AnikS22/golf-cart-code/Hardware/OneDrive_1_5-1-2026/Arduino Code/PGN Data.docx

PGN: 65300 Src: 0xFF Dest: 0x475

PGN: 61444 Src: 0xFF Dest: 0x475 Electronic Engine Controller 1

## 4th bit is voltage most likely and 5th bit is possibly speed

## Voltage pins right above pedal, able to measure

PGN: 61445 Src: 0xFF Dest: 0x475 Electronic Transmission Controller 2

## Forward = 70 6th

## Neutral = 78 6th

## Charging = 67 6th

## Reverse = : 255 255 255 255 32 82 255 25 6th

PGN: 61446 Src: 0xFF Dest: 0x475 Electronic Axle Controller 1

PGN: 64991 Src: 0xFF Dest: 0x475 Front wheel drive status

## Always null, possible lock up status

PGN: 65299 Src: 0xFF Dest: 0x475 -Change with no input

PGN: 65382 Src: 0xFF Dest: 0x475

PGN: 65265 Src: 0xFF Dest: 0x475 Cruise control/Vehicle Speed 1

## 3rd and 4th bit, 4th bit is most likely speed in mph

PGN: 15990542 Src: 0xFF Dest: 0x475

PGN: 15728391 Src: 0xFF Dest: 0x475 - Change with no input

PGN: 15990543 Src: 0xFF Dest: 0x475 - Change with no input

PGN: 15990545 Src: 0xFF Dest: 0x475 - Change with no input

PGN: 15990546 Src: 0xFF Dest: 0x475 -Change with no input
