AnikS22/golf-cart-code/Hardware/OneDrive_1_5-1-2026/Design Docs/Draft Accelerator Plan.xlsx

Accelerator System | 34-41 days | Comments
Reverse Engineer | 4 days | Need to find the correct bits per PGN (Basics already completed, would need to only do further reverse engineering if we get the code working)
Alternate Path if not workable | 0 - 7 days | Digital Pot, if applicable, this would take however many days shipping would be. Estimate 5-7 days for shipping
Implementing Protocol | 5 days | Getting Protocol to work (Once this works, we can control transmission/speed/etc
EMCU Selection | 1 day | Quick, once we get code working and have completed reverse engineering, picking EMCU with proper capatability will be easy.
Jetson to ECU Communcation code | 0 days | Would be done parallel to Electrical work
Mechanical Design for Mounting | 7 days | Planning, Prototyping, Troubleshooting, and Finalizing. This step is more tedious since we are using various boards.
Electrical Design | 7 days | Powering the arduino and jetson from the cart's battery
Electrical Validation | 3 days
Quality Control and Testing | 7 days | Want to go outside and test the cart, read temperatures of boards and ensure that the boards wont overheat
Electrical
Software
Mechanical
IDT
Accelerator System Complete | 34-41 days
