AnikS22/golf-cart-code/Hardware/OneDrive_1_5-1-2026/Design Docs/Draft Braking Plan.xlsx

Braking System | 56 days?
Evaluate Master Cylinder | 1 day?
Parts selection | 1 day?
Procurement | 1 day?
fabrication | 1 day?
Electrical Validation | 1 day?
 | 1 day?
Electrical | 5 days
Software | 5 days
Mechanical | 5 days
IDT | 5 days
Control System Complete | 0 days
CAD-modeling cockpit structure | 1-2 Weeks?
Basic (kinematic) concept of actuator with emergency override feature | 1-2 Weeks?
Force/stress analysis/synthesis | 1-2 Weeks?
IF APPLICABLE: 3D-printing/other mode of prototyping
Detailed design (fasteners, actuator types, etc.)
Spec'ing and selection of actuator and other components
Purchase
