AnikS22/golf-cart-code/Hardware/OneDrive_1_5-1-2026/Design Docs/Draft Control System Plan.xlsx

Control System | 36 days?
Assemble ROS Team | 1 day?
Evaluate ROS | 1 day?
Plan Implementation | 1 day?
 | 1 day?
Prototype Control System (not ROS) | 1 day?
Design wireless/wired hand controller
Design Arduino as controller
implement Prototype
 | 1 day?
Electrical | 5 days
Software | 5 days
Mechanical | 5 days
IDT | 5 days
Control System Complete | 0 days?
