AnikS22/golf-cart-code/Hardware/OneDrive_1_5-1-2026/Design Docs/Draft Steering Plan.xlsx

Steering System | 10 days?
Parts Selection | 1 day?
Procurement | 1 week?
Fabrication | 1 day?
3D Print Brackets | 1.5 weeks?
CNC Brackets | 1 week?
Assemble | 1 day?
Validate Assembly | 1 day?
Unit Test | 3 days?
Electrical Design | 1 day?
Electrical Validation | 1 day?
 | 1 day?
Electrical | 5 days
Software | 5 days
Mechanical | 5 days
IDT | 5 days
Steering System Complete | 0 days
