AnikS22/golf-cart-code/Hardware/OneDrive_1_5-1-2026/Design Docs/Resource Assignments.xlsx

Diego Jerez - Comp Sci | Accelerator
Yu ‘Joey’ Wu | Accelerator
Art Rozenbaum | Brakes
Kurtis Rodriques | Brakes
Louis-Cristophe Fortier | Brakes
Brandon Jadotte | Control System
Matt Trask | Control System
Michael Teti | ML
Chris Teti | Steering
Gregory Morrison - Mechanical | Steering
Tai Cao - Mechanical | Steering
Daniel Marquez
Regynald Augustin
