AnikS22/golf-cart-code/Hardware/OneDrive_1_5-1-2026/Vinyl Grafx/Proof Sheet 128038 - Golf Cart Graphics.pdf

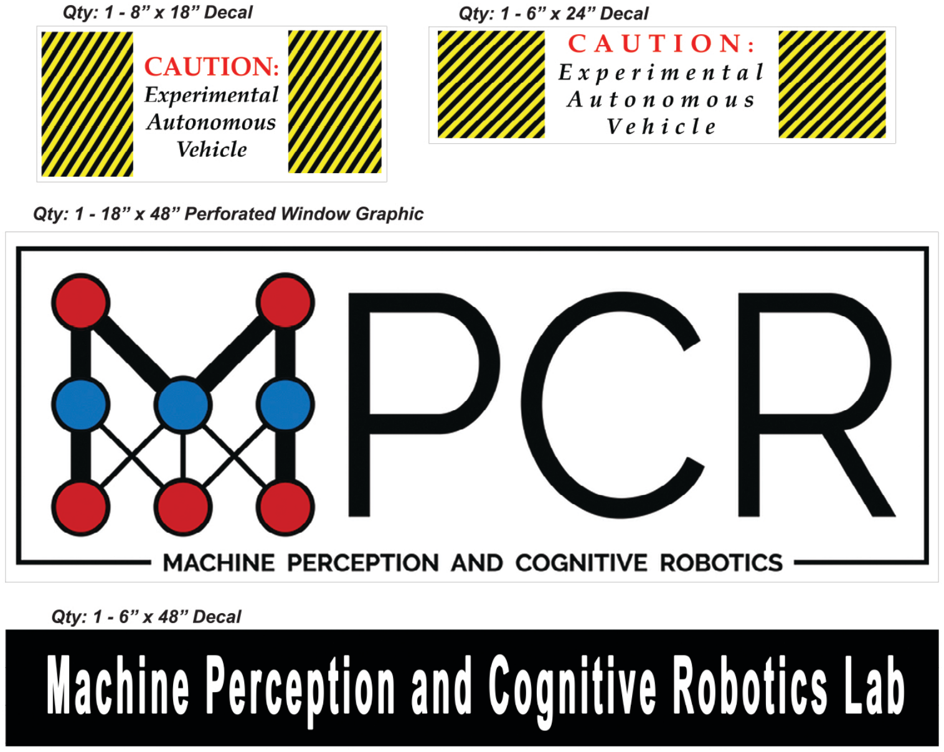
[picture p7: page 1]
