AnikS22/golf-cart-code/Old_code/steering/ReadMe.docx

READ.ME fir PiDuino Subsystem

07 Jan 2020 – PiDuino, v5 is the current working version as we add braking control

26 Dec 2019 – PiDuino,v 4 [Frozen] represents the re-constituted version that controls Steering only.

With bugfix for unsigned numbers on the LCD display.

The file “rc.local” is the autoStart file that runs the Piduino.py program as a shell process automatically on system startup. us “sudo cp rc.local /etc” in order to deploy it on a new system.

The file “PiDuino,v4 Image.dmg” is a Macintosh disk image file of the SD Card used in the Piduino. This snapshot is suitable for reproducing onto other 32gb SD cards as it contains the working image of PiDuino, v4.

NOTE: v4 is hereby frozen and the contents of this folder should not be modified. All future work begins in v5.
