AnikS22/golf-cart-code/Hardware/OneDrive_1_5-1-2026/Motor/EPAS-diagram.jpg

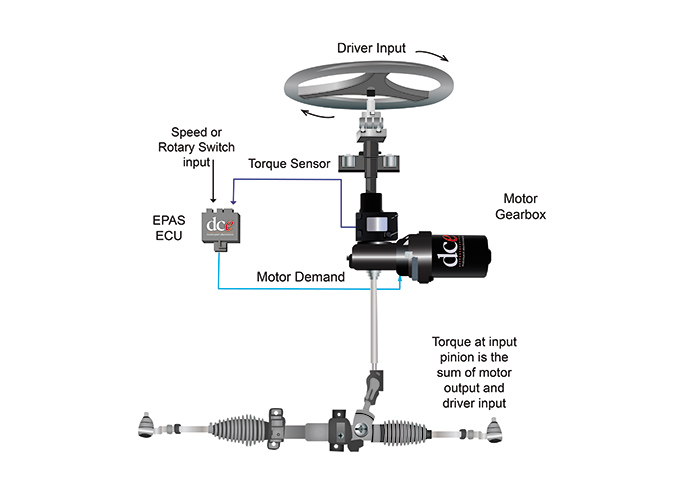
Hardware/OneDrive_1_5-1-2026/Motor/EPAS-diagram.jpg
