AnikS22/golf-cart-code/Sim/Cartagena_GEM_E4_workspace/ros2_ws/.gem.urdf

<?xml version="1.0" ?>
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
<robot name="gem_e4">
  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
  <link name="base_footprint">
  </link>
  <link name="base_link">
    <inertial>
      <origin rpy="0 0 0" xyz="-0.01178 0.0012042 0.47962"/>
      <mass value="1950.5"/>
      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
    </inertial>
    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
  </link>
  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
  <joint name="base_link" type="fixed">
    <origin rpy="0 0 0" xyz="0 0 0.268"/>
    <parent link="base_footprint"/>
    <child link="base_link"/>
  </joint>
  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
  <link name="top_rack_link">
    <inertial>
      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
      <origin rpy="0 0 0" xyz="0 0 0"/>
      <mass value="0"/>
      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
    </inertial>
    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
  </link>
  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
  <joint name="top_rack_joint" type="fixed">
    <origin rpy="1.5708 0 0" xyz="-0.17 0 1.66"/>
    <parent link="base_link"/>
    <child link="top_rack_link"/>
    <axis xyz="0 0 0"/>
  </joint>
  <link name="front_rack_link">
    <inertial>
      <origin rpy="0 0 0" xyz="0 0 0"/>
      <mass value="0"/>
      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
    </inertial>
    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
  </link>
  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
  <joint name="front_rack_joint" type="fixed">
    <origin rpy="1.5708 0 1.5708" xyz="1.7594 0 -0.15"/>
    <parent link="base_link"/>
    <child link="front_rack_link"/>
    <axis xyz="0 0 0"/>
  </joint>
  <link name="rear_rack_link">
    <inertial>
      <origin rpy="0 0 0" xyz="0 0 0"/>
      <mass value="0"/>
      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
    </inertial>
    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
  </link>
  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
  <joint name="rear_rack_joint" type="fixed">
    <origin rpy="1.5708 0 -1.5708" xyz="-1.7372 0 -0.1"/>
    <parent link="base_link"/>
    <child link="rear_rack_link"/>
    <axis xyz="0 0 0"/>
  </joint>
  <link name="headlight_fr_link">
    <inertial>
      <origin rpy="0 0 0" xyz="0 0 0"/>
      <mass value="0"/>
      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
    </inertial>
    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
  </link>
  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
  <joint name="headlight_fr_joint" type="fixed">
    <origin rpy="0 0 0" xyz="1.1677 -0.5 0.765"/>
    <parent link="base_link"/>
    <child link="headlight_fr_link"/>
    <axis xyz="0 0 0"/>
  </joint>
  <link name="headlight_fl_link">
    <inertial>
      <origin rpy="0 0 0" xyz="0 0 0"/>
      <mass value="0"/>
      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
    </inertial>
    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
  </link>
  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
  <joint name="headlight_fl_joint" type="fixed">
    <origin rpy="0 0 0" xyz="1.1677 0.5 0.765"/>
    <parent link="base_link"/>
    <child link="headlight_fl_link"/>
    <axis xyz="0 0 0"/>
  </joint>
  <link name="turnlight_fl_link">
    <inertial>
      <origin rpy="0 0 0" xyz="0 0 0"/>
      <mass value="0"/>
      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
    </inertial>
    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
  </link>
  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
  <joint name="turnlight_fl_joint" type="fixed">
    <origin rpy="0 0 0" xyz="1.1731 0.345 0.765"/>
    <parent link="base_link"/>
    <child link="turnlight_fl_link"/>
    <axis xyz="0 0 0"/>
  </joint>
  <link name="turnlight_fr_link">
    <inertial>
      <origin rpy="0 0 0" xyz="0 0 0"/>
      <mass value="0"/>
      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
    </inertial>
    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
  </link>
  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
  <joint name="turnlight_fr_joint" type="fixed">
    <origin rpy="0 0 0" xyz="1.1731 -0.345 0.765"/>
    <parent link="base_link"/>
    <child link="turnlight_fr_link"/>
    <axis xyz="0 0 0"/>
  </joint>
  <link name="lightbar_link">
    <inertial>
      <origin rpy="0 0 0" xyz="0 0 0"/>
      <mass value="0"/>
      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
    </inertial>
    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
  </link>
  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
  <joint name="lightbar_joint" type="fixed">
    <origin rpy="-1.9138 0 1.5708" xyz="-1.07655 0 0.9449"/>
    <origin rpy="0 0 0" xyz="0 0 0"/>
    <parent link="base_link"/>
    <child link="lightbar_link"/>
    <axis xyz="0 0 0"/>
  </joint>
  <link name="rear_left_stop_light_link">
    <inertial>
      <origin rpy="0 0 0" xyz="0 0 0"/>
      <mass value="0"/>
      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
    </inertial>
    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
  </link>
  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
  <joint name="stoplight_rl_joint" type="fixed">
    <origin rpy="0 0 3.1416" xyz="-1.625 0.38 0.423"/>
    <parent link="base_link"/>
    <child link="rear_left_stop_light_link"/>
    <axis xyz="0 0 0"/>
  </joint>
  <link name="rear_right_stop_light_link">
    <inertial>
      <origin rpy="0 0 0" xyz="0 0 0"/>
      <mass value="0"/>
      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
    </inertial>
    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
  </link>
  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
  <joint name="stoplight_rr_joint" type="fixed">
    <origin rpy="0 0 3.1416" xyz="-1.625 -0.38 0.423"/>
    <parent link="base_link"/>
    <child link="rear_right_stop_light_link"/>
    <axis xyz="0 0 0"/>
  </joint>
  <link name="taillight_rl_link">
    <inertial>
      <origin rpy="0 0 0" xyz="0 0 0"/>
      <mass value="0"/>
      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
    </inertial>
    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
  </link>
  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
  <joint name="taillight_rl_joint" type="fixed">
    <origin rpy="0 0 3.1416" xyz="-1.62 0.32 0.203"/>
    <parent link="base_link"/>
    <child link="taillight_rl_link"/>
    <axis xyz="0 0 0"/>
  </joint>
  <link name="taillight_rr_link">
    <inertial>
      <origin rpy="0 0 0" xyz="0 0 0"/>
      <mass value="0"/>
      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
    </inertial>
    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
  </link>
  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
  <joint name="taillight_rr_joint" type="fixed">
    <origin rpy="0 0 3.1416" xyz="-1.62 -0.32 0.203"/>
    <parent link="base_link"/>
    <child link="taillight_rr_link"/>
    <axis xyz="0 0 0"/>
  </joint>
  <link name="i_logo_fl_link">
    <inertial>
      <origin rpy="0 0 0" xyz="0 0 0"/>
      <mass value="0"/>
      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
    </inertial>
    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
  </link>
  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
  <joint name="i_logo_fl_joint" type="fixed">
    <origin rpy="0 0 0" xyz="0.3966 0.6695 0.4123"/>
    <parent link="base_link"/>
    <child link="i_logo_fl_link"/>
    <axis xyz="0 0 0"/>
  </joint>
  <link name="i_logo_rl_link">
    <inertial>
      <origin rpy="0 0 0" xyz="0 0 0"/>
      <mass value="0"/>
      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
    </inertial>
    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
  </link>
  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
  <joint name="i_logo_rl_joint" type="fixed">
    <origin rpy="0 0 0" xyz="-0.42344 0.6695 0.4123"/>
    <parent link="base_link"/>
    <child link="i_logo_rl_link"/>
    <axis xyz="0 0 0"/>
  </joint>
  <link name="i_logo_fr_link">
    <inertial>
      <origin rpy="0 0 0" xyz="0 0 0"/>
      <mass value="0"/>
      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
    </inertial>
    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
  </link>
  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
  <joint name="i_logo_fr_joint" type="fixed">
    <origin rpy="0 0 0" xyz="0.3966 -0.68 0.4123"/>
    <parent link="base_link"/>
    <child link="i_logo_fr_link"/>
    <axis xyz="0 0 0"/>
  </joint>
  <link name="i_logo_rr_link">
    <inertial>
      <origin rpy="0 0 0" xyz="0 0 0"/>
      <mass value="0"/>
      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
    </inertial>
    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
  </link>
  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
  <joint name="i_logo_rr_joint" type="fixed">
    <origin rpy="0 0 0" xyz="-0.42344 -0.68 0.4123"/>
    <parent link="base_link"/>
    <child link="i_logo_rr_link"/>
    <axis xyz="0 0 0"/>
  </joint>
  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
  <link name="gps_antenna_main_link">
    <inertial>
      <origin rpy="0 0 0" xyz="0 0 0"/>
      <mass value="0"/>
      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
    </inertial>
    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
  </link>
  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
  <joint name="gps_antenna_main_joint" type="fixed">
    <origin rpy="0 0 0" xyz="-0.01144 0.6525 1.7"/>
    <parent link="base_link"/>
    <child link="gps_antenna_main_link"/>
    <axis xyz="0 0 1"/>
  </joint>
  <link name="gps_antenna_aux_link">
    <inertial>
      <origin rpy="0 0 0" xyz="0 0 0"/>
      <mass value="0"/>
      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
    </inertial>
    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
  </link>
  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
  <joint name="gps_antenna_aux_joint" type="fixed">
    <origin rpy="0 0 0" xyz="-0.01144 -0.6525 1.7"/>
    <parent link="base_link"/>
    <child link="gps_antenna_aux_link"/>
    <axis xyz="0 0 1"/>
  </joint>
  <link name="top_lidar_link">
    <inertial>
      <origin rpy="0 0 0" xyz="0 0 0"/>
      <mass value="0"/>
      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
    </inertial>
    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
  </link>
  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
  <joint name="top_lidar_joint" type="fixed">
    <origin rpy="0 0 0" xyz="-0.15144 0 2.08"/>
    <parent link="base_link"/>
    <child link="top_lidar_link"/>
    <axis xyz="0 0 0"/>
  </joint>
  <link name="front_camera_link">
    <inertial>
      <origin rpy="0 0 0" xyz="0 0 0"/>
      <mass value="0"/>
      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
    </inertial>
    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
  </link>
  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
  <joint name="front_camera_joint" type="fixed">
    <origin rpy="0 1.5708 0" xyz="0.535 0 1.683"/>
    <parent link="base_link"/>
    <child link="front_camera_link"/>
    <axis xyz="0 0 0"/>
  </joint>
  <link name="front_lidar_link">
    <inertial>
      <origin rpy="0 0 0" xyz="0 0 0"/>
      <mass value="0"/>
      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
    </inertial>
    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
  </link>
  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
  <joint name="front_lidar_joint" type="fixed">
    <origin rpy="0 0 0" xyz="0.38206 0 1.71"/>
    <parent link="base_link"/>
    <child link="front_lidar_link"/>
    <axis xyz="0 0 0"/>
  </joint>
  <link name="front_radar_link">
    <inertial>
      <origin rpy="0 0 0" xyz="0 0 0"/>
      <mass value="0"/>
      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
    </inertial>
    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
  </link>
  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
  <joint name="front_radar_joint" type="fixed">
    <origin rpy="0 0 0" xyz="1.835 0 0.35"/>
    <parent link="base_link"/>
    <child link="front_radar_link"/>
    <axis xyz="0 0 0"/>
  </joint>
  <link name="imu_link">
    <inertial>
      <origin rpy="0 0 0" xyz="0 0 0"/>
      <mass value="0"/>
      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
    </inertial>
    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
  </link>
  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
  <joint name="imu_joint" type="fixed">
    <origin rpy="0 0 0" xyz="-0.0044387 0 0.18294"/>
    <parent link="base_link"/>
    <child link="imu_link"/>
    <axis xyz="0 0 0"/>
  </joint>
  <link name="vsm"/>
  <joint name="velocity_sensor_joint" type="fixed">
    <origin rpy="0 0 0" xyz="0.0 0 0.0"/>
    <parent link="imu_link"/>
    <child link="vsm"/>
  </joint>
  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
  <link name="left_steering_hinge_link">
    <inertial>
      <mass value="1"/>
      <origin rpy="0 0 0" xyz="0 0 0"/>
      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
    </inertial>
  </link>
  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
  <joint name="left_steering_hinge_joint" type="revolute">
    <parent link="base_link"/>
    <child link="left_steering_hinge_link"/>
    <origin rpy="0 0 0" xyz="1.2746 0.6545 0.027"/>
    <axis xyz="0 0 1"/>
    <limit effort="100" lower="-0.61" upper="0.61" velocity="0.5"/>
  </joint>
  <link name="front_left_wheel_link">
    <inertial>
      <mass value="11"/>
      <origin xyz="0 0 0"/>
      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
    </inertial>
    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
  </link>
  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
  <joint name="front_left_wheel_joint" type="continuous">
    <parent link="left_steering_hinge_link"/>
    <child link="front_left_wheel_link"/>
    <origin rpy="0 0 0" xyz="0 0 0"/>
    <axis xyz="0 1 0"/>
    <limit effort="1000" velocity="100.0"/>
  </joint>
  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
  <link name="right_steering_hinge_link">
    <inertial>
      <mass value="1"/>
      <origin rpy="0 0 0" xyz="0 0 0"/>
      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
    </inertial>
  </link>
  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
  <joint name="right_steering_hinge_joint" type="revolute">
    <parent link="base_link"/>
    <child link="right_steering_hinge_link"/>
    <origin rpy="0 0 0" xyz="1.2746 -0.6535 0.027"/>
    <axis xyz="0 0 1"/>
    <limit effort="100" lower="-0.61" upper="0.61" velocity="0.5"/>
  </joint>
  <link name="front_right_wheel_link">
    <inertial>
      <mass value="11"/>
      <origin xyz="0 0 0"/>
      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
    </inertial>
    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
  </link>
  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
  <joint name="front_right_wheel_joint" type="continuous">
    <parent link="right_steering_hinge_link"/>
    <child link="front_right_wheel_link"/>
    <origin rpy="0 0 0" xyz="0 0 0"/>
    <axis xyz="0 1 0"/>
    <limit effort="1000" velocity="100.0"/>
  </joint>
  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
  <link name="rear_left_wheel_link">
    <inertial>
      <mass value="11"/>
      <origin xyz="0 0 0"/>
      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
    </inertial>
    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
  </link>
  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
  <joint name="rear_left_wheel_joint" type="continuous">
    <origin rpy="0 0 0" xyz="-1.2904 0.6545 0.027"/>
    <parent link="base_link"/>
    <child link="rear_left_wheel_link"/>
    <axis xyz="0 1 0"/>
    <limit effort="1000.0" velocity="100.0"/>
  </joint>
  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
  <link name="rear_right_wheel_link">
    <inertial>
      <mass value="11"/>
      <origin xyz="0 0 0"/>
      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
    </inertial>
    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
  </link>
  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
  <joint name="rear_right_wheel_joint" type="continuous">
    <origin rpy="0 0 0" xyz="-1.2904 -0.6535 0.027"/>
    <parent link="base_link"/>
    <child link="rear_right_wheel_link"/>
    <axis xyz="0 1 0"/>
    <limit effort="1000.0" velocity="100.0"/>
  </joint>
  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
  <joint name="os_sensor_mount_joint" type="fixed">
    <origin rpy="1.5708 0 3.1416" xyz="0.02 0.42 0"/>
    <parent link="top_rack_link"/>
    <child link="os_sensor"/>
  </joint>
  <link name="os_sensor">
    <inertial>
      <mass value="0.33"/>
      <origin rpy="0 0 0" xyz="0 0 0.0365"/>
      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
    </inertial>
    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
  </link>
  <link name="os_imu"/>
  <link name="os_lidar"/>
  <joint name="os_sensor_imu_link_joint" type="fixed">
    <parent link="os_sensor"/>
    <child link="os_imu"/>
    <origin rpy="0 0 0" xyz="0.006253 -0.011775 0.007645"/>
  </joint>
  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
  <joint name="os_sensor_lidar_link_joint" type="fixed">
    <parent link="os_sensor"/>
    <child link="os_lidar"/>
    <origin rpy="0 0 0" xyz="0.0 0.0 0.03618"/>
  </joint>
  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
  <link name="front_single_camera_link">
    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
    <inertial>
      <mass value="1e-5"/>
      <origin rpy="0 0 0" xyz="0 0 0"/>
      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
    </inertial>
  </link>
  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
  <joint name="gem_front_camera_joint" type="fixed">
    <origin rpy="0 -1.57 0" xyz="0 0 0"/>
    <parent link="front_camera_link"/>
    <child link="front_single_camera_link"/>
  </joint>
  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
  <link name="front_left_corner_camera_link">
    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
    <inertial>
      <mass value="1e-5"/>
      <origin rpy="0 0 0" xyz="0 0 0"/>
      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
    </inertial>
  </link>
  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
  <joint name="front_left_corner_camera_joint" type="fixed">
    <origin rpy="0 0.785 0.785" xyz="0.5 0.6545 1.75"/>
    <parent link="base_link"/>
    <child link="front_left_corner_camera_link"/>
    <axis xyz="0 0 0"/>
  </joint>
  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
  <link name="front_right_corner_camera_link">
    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
    <inertial>
      <mass value="1e-5"/>
      <origin rpy="0 0 0" xyz="0 0 0"/>
      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
    </inertial>
  </link>
  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
  <joint name="front_right_corner_camera_joint" type="fixed">
    <origin rpy="0 0.785 -0.785" xyz="0.5 -0.6535 1.75"/>
    <parent link="base_link"/>
    <child link="front_right_corner_camera_link"/>
    <axis xyz="0 0 0"/>
  </joint>
  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
  <link name="rear_left_corner_camera_link">
    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
    <inertial>
      <mass value="1e-5"/>
      <origin rpy="0 0 0" xyz="0 0 0"/>
      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
    </inertial>
  </link>
  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
  <joint name="rear_left_corner_camera_joint" type="fixed">
    <origin rpy="0 0.785 2.356" xyz="-1.0 0.6545 1.75"/>
    <parent link="base_link"/>
    <child link="rear_left_corner_camera_link"/>
    <axis xyz="0 0 0"/>
  </joint>
  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
  <link name="rear_right_corner_camera_link">
    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
    <inertial>
      <mass value="1e-5"/>
      <origin rpy="0 0 0" xyz="0 0 0"/>
      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
    </inertial>
  </link>
  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
  <joint name="rear_right_corner_camera_joint" type="fixed">
    <origin rpy="0 0.785 -2.356" xyz="-1.0 -0.6535 1.75"/>
    <parent link="base_link"/>
    <child link="rear_right_corner_camera_link"/>
    <axis xyz="0 0 0"/>
  </joint>
  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
  <link name="IMU_link">
    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
    <inertial>
      <origin rpy="0 0 0" xyz="0 0 0"/>
      <mass value="1"/>
      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
    </inertial>
  </link>
  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
  <joint name="IMU_joint" type="fixed">
    <origin rpy="0 0 -1.5708" xyz="-0.246 0 0.05"/>
    <parent link="base_link"/>
    <child link="IMU_link"/>
  </joint>
  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
  <link name="GPS_link">
    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
    <inertial>
      <origin rpy="0 0 0" xyz="0 0 0"/>
      <mass value="1"/>
      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
    </inertial>
  </link>
  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
  <joint name="GPS_joint" type="fixed">
    <origin rpy="0 0 0" xyz="-0.246 0 0.05"/>
    <parent link="base_link"/>
    <child link="GPS_link"/>
  </joint>
  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
  <link name="front_sonar_link">
    <inertial>
      <mass value="0.001"/>
      <origin rpy="0 0 0" xyz="0 0 0"/>
      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
    </inertial>
    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
  </link>
  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
  <joint name="front_sonar_joint" type="fixed">
    <origin rpy="0 -1.5708 -1.5708" xyz="0 0.38 0.065"/>
    <parent link="front_rack_link"/>
    <child link="front_sonar_link"/>
  </joint>
  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
  <link name="rear_sonar_link">
    <inertial>
      <mass value="0.001"/>
      <origin rpy="0 0 0" xyz="0 0 0"/>
      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
    </inertial>
    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
  </link>
  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
  <joint name="rear_sonar_joint" type="fixed">
    <origin rpy="0 -1.5708 -1.5708" xyz="0 0.38 0.065"/>
    <parent link="rear_rack_link"/>
    <child link="rear_sonar_link"/>
  </joint>
</robot>
