AnikS22/golf-cart-code/Hardware/OneDrive_1_5-1-2026/Arduino Code/J1939 Receiving Messages/J1939_Receiving_Messages.ino

// ------------------------------------------------------------------------
//  J1939 - Receiving Messages
// ------------------------------------------------------------------------
//
// IMPOPRTANT: Depending on the CAN shield used for this programming sample,
//             please make sure you set the proper CS pin in module can.cpp.
//
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
#include <stdlib.h>
#include <SPI.h>
#include "mcp_can.h"
#include "can_ext.h"

// ------------------------------------------------------------------------
//  SYSTEM: Setup routine runs on power-up or reset
// ------------------------------------------------------------------------
void setup()
{
  // Set the serial interface baud rate
  Serial.begin(115200);
  
  // Initialize the CAN controller
  if (canInitialize(CAN_250KBPS) == CAN_OK)  // Baud rates defined in mcp_can_dfs.h
    Serial.print("CAN Init OK.\n\r\n\r");
  else
    Serial.print("CAN Init Failed.\n\r");
    
}// end setup

// ------------------------------------------------------------------------
// Main Loop - Arduino Entry Point
// ------------------------------------------------------------------------
void loop() 
{
  // Declarations
  byte nPriority;
  byte nSrcAddr;
  byte nDestAddr;
  byte nData[8];
  byte oldData[8];
  int nDataLen;
  long lPGN;
  int PGN = 61445;
 
  char sString[80];
  
  // Check for received J1939 messages
  if(j1939Receive(&lPGN, &nPriority, &nSrcAddr, &nDestAddr, nData, &nDataLen) == 0)
  {
        // sprintf(sString, "PGN: %ld Src: 0x%X Dest: 0x%X ", (int)lPGN, nSrcAddr, nDestAddr);
        // Serial.print(sString);
        if(nDataLen == 0 )
          Serial.print("No Data.\n\r");
        else
        {if(PGN == (int)lPGN )
        {
          sprintf(sString, "PGN: %li, Dest: 0x%X", (long)lPGN,nDestAddr );
          Serial.print(sString);
          Serial.print("Data: ");
          for(int nIndex = 0; nIndex < nDataLen; nIndex++)
          {          
            sprintf(sString, "%d ", nData[nIndex]);
            Serial.print(sString);
         
          
          }// end for
          delay(1000);
        }
        
          Serial.print("\n\r");
          
        }// end else
        
  }// end if
  
}// end loop
