AnikS22/golf-cart-code/(commit log)

2026-05-01 Initial commit: FAU MPCR self-driving GEM E4 conversion
    Master plan, hardware system design, drive-by-wire translation
    architecture, canonical CAN protocol header, sensor URDF xacro for
    the digital twin, and recovered 2020-era artifacts (EPAS18 Ultra
    docs, J1939 PGN data, ARD1939 stack, design plans). Sim foundation
    adopted from Cartagena_GEM_E4_workspace.
    [.gem.sdf, .gem.urdf, Draft Accelerator Plan.xlsx, Draft Braking Plan.xlsx, Draft Control System Plan.xlsx, Draft Steering Plan.xlsx, Resource Assignments.xlsx, fau_breezeway.sdf]
2026-05-01 Establish digital-twin consistency discipline
    - Move sensor xacro into Sim/urdf/ for proper package layout
    - Add Sim/urdf/cart_parameters.xacro as canonical source of truth for
    vehicle geometry, dynamics, sensor extrinsics, sensor specs, and ROS
    topic names. Both sim URDF and real-cart URDF will <xacro:include>
    this single file
    - Refactor sensor xacro to consume parameters via ${EXT_*}/${TOPIC_*}
    properties — no hard-coded values
    - Add Hardware/cart_parameters.md as human-readable mirror for
    procurement / mechanical / controls reference
    - Add Sim/digital_twin_consistency.md documenting the rules:
    single sources of truth, no duplicate parameters, calibration
    flows one way (rea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
    [cart_parameters.xacro, gem_e4_sensors.urdf.xacro]
2026-05-01 Refactor sensor xacro to consume cart_parameters.xacro properties
    Replace every hard-coded XYZ/yaw/FOV/rate/topic literal with
    ${EXT_*}/${TOPIC_*}/${LIDAR_*}/etc. property references. Now the
    sensor URDF has zero parameters of its own — all values flow from
    the canonical cart_parameters.xacro.
    This is the consistency-discipline payoff: changing a sensor pose
    (after real-cart calibration) is a one-line edit in
    cart_parameters.xacro that propagates to both sim and real-cart
    URDF generation.
    [gem_e4_sensors.urdf.xacro]
2026-05-01 Build out gem_sim + sim_dbw_bridge ROS 2 packages; auto-commit infra
    gem_sim package (Sim/Cartagena_GEM_E4_workspace/ros2_ws/src/gem_sim/):
    - Top-level gem_e4_robot.urdf.xacro that wires upstream chassis URDF
    with cart_parameters.xacro (canonical source of truth) and the
    sensor stack. Includes Gazebo Harmonic AckermannSteering, joint
    state, pose, and odometry plugins.
    - ros_gz_bridge.yaml maps every Gazebo sensor topic to the canonical
    ROS topic name (matches cart_parameters.xacro TOPIC_*). Same names
    the real cart will publish on.
    - sim_full.launch.py brings up Gazebo + spawn + RSP + bridge +
    sim_dbw_bridge in one shot.
    sim_dbw_bridge package (.../src/sim_dbw_bridge/):
    - Python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
    [cart_parameters.xacro, gem_e4_robot.urdf.xacro, gem_e4_sensors.urdf.xacro]
2026-05-03 macOS Docker sim env, CAD recommendation, cart visit checklist, status+timeline
    - Sim/macos/{Containerfile.macos, entrypoint.sh, README.md} — full ROS 2 +
    Gazebo Harmonic dev environment in a Linux container with browser-based
    GUI via noVNC. No XQuartz / X11 / VM needed. Apple Silicon compatible.
    - bin/sim_macos.sh — one-shot build/run/shell/stop for the macOS Docker env.
    First run builds image (~30 min one-time bake), then frictionless.
    - bin/preview_urdf.sh + Sim/preview/gem_e4_preview.urdf.xacro — flatten the
    digital-twin URDF on macOS (no ROS install needed) for Foxglove preview.
    - Hardware/CAD_RECOMMENDATION.md — Fusion 360 Personal recommended for
    bracketry/enclosure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
    [cart_parameters.xacro, gem_e4_preview.urdf, gem_e4_preview.urdf.xacro, gem_e4_sensors.urdf.xacro]
2026-05-03 Cleanup: drop regenerable preview artifacts; remove stray .tmp
    - bin/sim_macos.sh: remove leftover cp to entrypoint.sh.tmp (junk).
    - Sim/macos/entrypoint.sh.tmp: deleted from disk + repo.
    - Sim/preview/{cart_parameters.xacro, gem_e4_sensors.urdf.xacro,
    gem_e4_preview.urdf}: gitignored. preview_urdf.sh regenerates them
    by copying from gem_sim/urdf/. Avoids stale duplicates drifting
    from the canonical source.
    [cart_parameters.xacro, gem_e4_preview.urdf, gem_e4_sensors.urdf.xacro]
2026-05-03 Cross-device resume: memory in repo via symlink + setup script
    - .claude/memory/ now contains the canonical Claude Code memory files
    (project, user, feedback, EPAS18 ref, J1939 ref, MEMORY index).
    On the original Mac, ~/.claude/projects/.../memory is now a symlink
    to this directory, so memory writes auto-flow through the repo.
    - .claude/README.md explains what does and doesn't sync.
    - bin/setup_new_machine.sh — idempotent setup for any new machine:
    computes Claude Code's encoded-cwd, creates the memory symlink,
    reports tooling status (git/gh/brew/Docker/Foxglove), notes
    auto-commit availability per OS. Tested locally — already-correct
    symlink is detected and left alone.
    - C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
2026-05-03 README: inline the cross-device resume instructions
    Promote the cross-device resume flow from a one-liner + link into a
    full section in the README itself: quick start, how it works (symlink
    mechanism), path-encoding gotcha (slash + space → dash), Linux-side
    flow with cron, second-Mac flow, what does and doesn't travel via
    the repo, limitations.
    CROSS_DEVICE_RESUME.md still holds the canonical reference; README
    now stands alone for anyone landing on the repo home page.
2026-05-04 Real Teensy firmware: motion + pedals (PlatformIO, ~900 lines)
    motion_teensy/src/main.cpp (~375 lines):
    - 2× FlexCAN_T4 buses (DBW + EPAS)
    - Hard 200 Hz IntervalTimer for EPAS msg #3 (DCE Motorsport protocol)
    - 100 Hz RX of EPAS msgs #1/#2; republish on DBW as STEER_STATUS +
    STEER_TORQUE_RAW
    - Outer position-PI loop (commanded centideg → torque demand)
    - Manual override detection: torque sensor raw bits spike >8 bits for
    >50 ms → set EPAS msg #3 D0=0, FAULT
    - Watchdogs: Jetson HB lost >100 ms → fault; EPAS msg stale >250 ms → fault
    - Status LED encodes state via blink rate; 1 Hz serial console dump
    pedals_teensy/src/main.cpp (~525 lines):
    - 2× FlexCAN_T4 (D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
2026-05-04 Cart-control plan + real-cart ROS↔CAN bridge + gamepad teleop
    Software/CART_CONTROL_PLAN.md — focused end-to-end plan for ROS-based
    manual control of the cart (no autonomy, no perception). What hardware,
    where it wires, what code links to what, what it runs on, the boot
    sequence, and the bench→cart test order. Phase 0c of the master plan.
    Software/autonomy_ws/src/gem_dbw_bridge/ — ROS 2 Python package. Real-
    cart equivalent of sim_dbw_bridge: subscribes to /dbw/cmd, emits CAN
    frames on can0 via python-can. Thin pass-through; the master state
    machine + safety gates live on the Pedals Teensy. ~295 lines.
    Software/autonomy_ws/src/gem_teleop/ — ROS 2 Python package. Logitech
    F710 gam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
2026-05-04 Linux quickstart: bin/setup_linux.sh + LINUX_QUICKSTART.md
    Pivoting Mac sim attempts to a clean Linux clone-and-go path. Apple
    Silicon under Rosetta breaks Gazebo's shared-memory tracker; native
    arm64 osrf/ros image doesn't exist; native macOS Gazebo + ROS 2 is
    fragile. Linux is the right host.
    bin/setup_linux.sh — idempotent one-shot setup for Ubuntu 22.04:
    1. ROS 2 Humble (apt)
    2. Gazebo Harmonic + ros-humble-ros-gzharmonic bridge
    3. Per-pkg deps (xacro, joy, ackermann_msgs, rviz2, can-utils,
    python-can)
    4. Clone upstream UIUC gem_ws + GEM-Illinois gem-simulator
    5. rosdep resolve + colcon build
    6. Optionally launch (`bin/setup_linux.sh launch`)
    Re-runnable; skips alre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
    [gem_e4_sensors.urdf.xacro]
2026-05-04 Jetson sim bring-up: launch fixes, plug layout, partial native run
    bin/setup_linux.sh — fix two bugs surfaced bringing this up on a real
    Jetson Orin NX (Yahboom) with Ubuntu 22.04 + JetPack 6.x:
    * ros-humble-ros-gzharmonic doesn't exist — fall back to the
    ros-humble-ros-gz-sim subpackages that ARE installed.
    * ROS 2 setup.bash trips set -u with unbound vars; wrap source
    in set +u/-u.
    Sim/.../gem_sim/launch/sim_full.launch.py:
    * Wrap xacro Command output in ParameterValue(value_type=str) so
    ROS 2 launch doesn't try to YAML-parse the URDF.
    * Render URDF to /tmp via OpaqueFunction and spawn with -file
    instead of -topic (Humble RSP doesn't publish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
    [gem_e4_robot.urdf.xacro]
2026-05-04 Jetson is the DBW CAN gateway, not a sim host
    Refresh after losing the plot mid-session and trying to run Gazebo on
    the Jetson. The Jetson runs gem_dbw_bridge (ROS↔CAN to Teensies) and
    gem_teleop (gamepad → /dbw/cmd). Sim runs OFF-cart.
    Hardware/JETSON_WIRING_DIAGRAM.md (new) — concrete port-by-port wiring:
    USB-A ❶ = gamepad receiver
    USB-A ❷–❹ = sensors / hub later
    Ethernet ❺ = LiDAR / dev internet
    USB-C ❻ = current Mac link / future ZED 2i
    HDMI ❼ = optional monitor
    DC barrel ❽ = cart 19 V power
    40-pin CAN_H/L ❾ = DBW bus to Teensies (kernel can0 already up)
    Plus boot sequence, systemd unit template, verification checklist.
    Memory: feedback_jetson_ro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
2026-05-05 Add canonical wiring diagram (Hardware/WIRING_DIAGRAM.md)
    Single doc with GitHub-rendered Mermaid graphs for:
    1. End-to-end data flow (sensors → autonomy → DBW → actuators)
    2. CAN topology — three isolated buses (DBW / EPAS / J1939)
    3. Power one-line + fuse block layout
    4. Safety kill-chain (software is NEVER in the drop path)
    5. Per-zone cabling — 7 zones connected by 3 channels (R/D/S)
    6. Jetson Orin NX Super port assignments (Yahboom carrier)
    7. Phase 0c first-light minimum wiring (just gamepad → cart, ≤5 mph)
2026-05-06 Jetson runtime: systemd units + run_cart.sh shortcut, all version-controlled
    After verifying all 8 ROS topics flow correctly (gem_dbw_bridge_node:
    opens can0 @ 500 kbps, publishes /dbw/{cmd,enable} +
    /vehicle/{master_state,fault_flags,speed_mps,gear,voltage_v,steering_rad}),
    made the runtime persistent + plug-and-go on the Jetson.
    Hardware/jetson_runtime/ — committed copies of:
    can0-up.service Bring up can0 @ 500 kbps at boot (enabled)
    gem-cart-runtime.service Auto-launch teleop stack (created, NOT
    auto-enabled — start manually until trusted)
    run_cart.sh One-shot launcher: ensures can0 up, sources ROS,
    launche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
2026-05-06 Add CLAUDE.md (auto-loaded project context for every Claude session)
    Tight summary of the project for any Claude Code session that opens the
    repo: architecture in one paragraph, folder map, critical non-obvious
    gotchas (Jetson is DBW gateway not sim host; EPAS18 is DCE Motorsport
    needing autonomous firmware variant; GEM CAN is J1939; macOS ROS 2 is
    fragile), build/run commands per platform, cross-device resume flow,
    current verified-working state, and working norms the user prefers
    (prior-art citations, procurement-detail planning, terse summaries).
    Lives at repo root so it loads on every claude session in this project.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
2026-05-13 Add Hardware/SHOPPING_LIST.md — tiered Amazon-and-direct procurement list
    Tier 1 firmware bench (~$310): 2× Teensy 4.1, CANable 2.0, TJA1051T/3
    ×4, MCP4725 ×2, MCP6002, Omron G8HE relay ×2, ISO1042, PC817,
    MPR121, F710 gamepad, Belden 9841, Deutsch DT kit, breadboard.
    Amazon-shoppable except the relays (Mouser) and ISO1042 (DigiKey).
    Tier 2 power + safety (~$450-950 depending on pack voltage):
    Pololu DC-DC stack, Vicor DCM3623 OR Mean Well RSDW20H-12,
    Battle Born or Renogy LiFePO4, Blue Sea fuse block + ANL fuses,
    4/14/22 AWG wire, IDEC mushroom E-stops, TE Kilovac LEV200,
    dash buttons + LEDs. Pack-voltage-conditional Vicor vs Mean Well.
    Tier 3 sensors (~$5,200): Livox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
2026-05-13 Add PRIMER.md — plain-language project orientation
    After user asked for "one document with all of the TL;DR of what I need
    to know" — they're learning the mech/electrical side from scratch and
    the prior docs were too dense. This is the orientation that should be
    read FIRST.
    Sections:
    1. 30-second version of the project
    2. The layer cake (autonomy → DBW → MCU → actuator → cart)
    3. Each hardware piece explained in plain English (Jetson, Teensies,
    EPAS18 ECU, traction controller, CAN bus, DACs, relays, sensors,
    safety hardware)
    4. How a command travels from gamepad to wheel
    5. How power flows
    6. Three independent ways the cart stops (hardware kill chain,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
2026-05-13 PRIMER.md §10: expand "phases" into full step-by-step roadmap
    User asked: "make sure it has a summary of everything that we are going
    to do". The previous §10 was a single status table — too thin. Replaced
    with a six-phase roadmap with concrete steps, demo gates, and costs:
    Phase 0a inspection ($25, Week 1)
    Phase 0b firmware bench ($310, Weeks 1-3)
    Phase 0c RC first-light ($450, Weeks 4-6)
    Phase 1 sensors + mapping ($5,200, Weeks 5-12)
    Phase 2 autonomous waypoint ($300, Weeks 13-24)
    Phase 3 perception + pedestrians ($250, Months 6-9)
    Phase 4 unmanned ($2,200 for AGX Orin, Months 9-12+)
    Each phase: numbered steps, demo gate, status emojis.
    Running cost/time totals at the b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
2026-05-13 PRIMER §11: practical skills + tools + pitfalls
    User asked the PRIMER also include "everything I need to understand
    and things" — adding the practical workshop/skills/pitfalls layer
    that the theory sections leave out.
    New §11 covers:
    - Physical tools to acquire (multimeter, soldering iron, Deutsch crimper,
    bench supply, etc.) with prices and when to buy
    - Software tools to install (Foxglove, VS Code, Fusion 360)
    - 7 skills to develop (multimeter, soldering, schematic-reading, candump,
    Deutsch crimping, launch files, Linux terminal) with YouTube search
    terms
    - Testing methodology: breadboard → bench supply → component-by-component
    → scope verify → jack-sta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
2026-05-13 PRIMER §12: the underlying lessons (why the architecture is what it is)
    23 lessons across three buckets:
    Engineering (1-8):
    Software is never in the kill path
    Single source of truth, propagated everywhere
    Fault domain separation
    Build small, integrate one piece at a time
    Defense in depth on safety
    Use existing parts when possible
    Cite prior art before deciding architecture
    Procurement detail matters in plans
    Project & process (9-14):
    Demo gates, not date gates
    Approvals are the long pole
    Document discipline saves projects (vs 2020 team's loss)
    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
2026-06-11 Kartech 1A001HAJ brake actuator: J1939 driver + Pedals serial UI
    Replaces the planned BTS7960+PA-14P brake stack with the actual hardware:
    the 2020 team's Kartech 1A001HAJ linear actuator (J1939, PGN 65280) is
    what was procured. The 2020 BrakeDuino Arduino source was recovered from
    Teams and the captured CAN frames are ported bit-for-bit to Teensy 4.1
    FlexCAN_T4 with a new parameterized API for continuous brake control.
    Software/firmware/common/include/kartech_brake.h (new)
    Header-only, templated FlexCAN_T4 driver. Captured 2020 frames
    (clutch_on/off, brake_full, release_to_stock, extend_3in, retract,
    brake_light) preserved bit-for-bit. New parameterized API:
    send_position_14bit(),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
    [ARD1939.h, BrakeDuino.c, BrakeDuino_copy_20260611172403.ino, kartech_brake.h, main.cpp]
2026-06-11 Docs: strike all BTS7960 + PA-14P refs; Kartech 1A001HAJ is the brake
    Follow-up to 7aa4934 — clean up every doc that still described the old
    H-bridge plan so future readers don't see contradictory architectures.
    * Masterplan.md: brake row, Tier 5 BOM row, channel S09 (was brake-pot
    cable, now CAN), Pedals MCU 100Hz loop entry replaced with 50Hz
    send_brake_permil() on CAN3.
    * Hardware/system_design.md C.4: actuator + driver + transceiver table
    reflects internal servo (no external H-bridge). Tier 6 dropped from
    ~$300 to ~$110.
    * Hardware/WIRING_DIAGRAM.md: brake actuator node + F8 fuse note.
    * Hardware/SHOPPING_LIST.md: drop PA-14P and BTS7960; add SN65HVD230
    for CAN3; subtotal $3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
2026-07-02 Snapshot full project for Linux transfer: plan, hardware, firmware, sim
    Captures the complete state of the GEM E4 self-driving conversion so it can
    be cloned onto the Linux build machine:
    - Docs: Masterplan, PRIMER, STATUS, CART_CONTROL_PLAN, README, wiring diagrams,
    shopping list, system design, cart-visit checklist (materials, plan, goals,
    progress).
    - Firmware: motion_teensy + pedals_teensy sources, shared dbw_can_protocol.h
    (bench-diagnostic edits to motion main.cpp and the protocol header).
    - Recovered 2020 artifacts restored (EPAS18 datasheet, ROS/TensorRT notes).
    - Old_code/: original 2020 SteerDuino + BrakeDuino/ARD1939 reference code.
    - Sim/openpilot_sim: our integration code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
2026-07-10 Steering works: EPAS18 driven via CAN on the bench (0x298 @ 250k)
    First-light steering achieved 2026-07-10. Commanded the EPAS18 Ultra ECU
    over CAN and turned the column: selected_map echoed, remote-mode bit set,
    motor duty/current/steering angle all responded. Reverts cleanly to local
    power-assist on stop. No faults throughout.
    Two wrong constants were the whole blocker (both verified on hardware):
    - EPAS bus bitrate is 250 kbps, not 500. At 500k the controller synced to
    edges but decoded zero frames (REC pinned) — looked like a dead bus.
    - Command msg #3 ID is 0x298, not the manual's 0x296. 0x296 frames were
    ACK'd at the CAN bit level then dropped by the ECU's ID filter, whi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
    [dbw_can_protocol.h, drive.py, main.cpp]
2026-07-17 Kar-Tech brake: decode full protocol from datasheet + add bench firmwares
    Obtained the official 1A001HAJ CAN Actuator datasheet (rev 1.30) and fully
    decoded the J1939 protocol, closing all four open questions in the reference:
    - HAJ = 3" stroke, 10-30VDC, 5.8A, negative-ground
    - Command ID 0x18FF0000, Report ID 0x18FF0001 (default), 250k, 29-bit ext
    - Position cmd: counts = inches*1000 + 500; clutch=byte3 b7, motor=b6
    - Feedback = Enhanced Position Report (byte0=152): shaft pos, err bits, mA
    Add two bench firmwares (Teensy 4.1, CAN2 @ 250k, same transceiver as steering):
    - brake_test_teensy: keyboard-driven position command w/ clutch sequencing,
    deadman, + brake.py driver
    -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
2026-07-17 Kar-Tech brake: RESOLVED — priority-0 addressing, comms fully working
    Bench diagnosis (via brake_sniff_teensy) found the actuator is an old 2018 unit
    that FILTERS ON J1939 PRIORITY. It transmits and accepts commands at priority 0,
    not the priority-6 form the docs implied:
    - Command ID = 0xFF0000 (raw 0x00FF0000), NOT 0x18FF0000
    - Report ID = 0xFF0001 (raw 0x00FF0001), NOT 0x18FF0001
    Confirmed by: (1) sniffer saw its 0xFF0001 heartbeat while it ignored our prio-6
    commands; (2) a Confirmation-flag command at 0xFF0000 got our exact frame echoed
    back; (3) after fixing brake_test to prio-0, a passive read returns a clean
    Enhanced Position Report: pos=1.756in, cur=2mA, err=0x0 — healthy,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
    [main.cpp]
2026-07-17 Kar-Tech brake: MOTION CONFIRMED — control proven, needs mechanical linkage
    Logged engage->extend->retract move: pos tracked tgt within ~0.04" both ways.
    Extend ~2mA (free), retract climbed to 5121mA (near 5.8A max). Shaft strokes
    correctly; actuator + firmware are done. Pedal doesn't move only because the
    rod isn't mechanically coupled to it yet (stroking in open air).
    Remaining work is purely mechanical: Kar-Tech linkage kit 1A0018A (clevis +
    rod-end) or custom bracket rod-eye -> pedal arm. Then: confirm apply direction,
    and cap force via Motor-Over-Current (0x7E) so it can't slam the pedal.
    Claude-Session: https://cl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
2026-07-17 docs: sync all docs to bench-verified steering + brake facts
    Steering (EPAS18): 0x296 -> 0x298 and EPAS bus 500k -> 250k across all docs;
    mark autonomous-firmware gate CLOSED (bench-steered 2026-07-10); drop mirror-byte
    (D1+D2=255) assumption (not needed on this unit); supersede the draft DCE email.
    Brake (Kar-Tech 1A001HAJ): correct any BTS7960/PA-14P H-bridge framing to the
    J1939 CAN actuator (already owned); note bench-confirmed 2026-07-17, priority-0
    addressing (cmd 0xFF0000 / report 0xFF0001), and mechanical-linkage-only gap.
    Files: STATUS.md, CLAUDE.md, PRIMER.md, Masterplan.md, Software/README.md,
    Software/CART_CONTROL_PLAN.md, Software/dbw_translation_architecture.md,
    Software/firm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
2026-07-17 Add ROS<->Teensy DBW integration plan (plan only, not started)
    Software/ROS_INTEGRATION_PLAN.md: grounded map + workstreams for wiring the
    Jetson ROS stack to the Teensies. Key finding: the ROS graph (gem_dbw_bridge,
    gem_teleop, dbw_can_protocol.h, Pedals state machine) already exists and is
    smoke-tested — the real gap is firmware:
    - Motion Teensy EPAS TX is commented out (steering does nothing yet)
    - both firmwares still carry disproven protocol (EPAS mirror byte; Kar-Tech
    0xFF0080 + wrong byte3, clutch/motor bits never set)
    Plan = reconcile protocol to bench facts (no-mirror 0x298; Kar-Tech priority-0
    0xFF0000 counts+500 w/ clutch-motor staging) + port proven steer_test/brake_te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
2026-07-30 teleop_serial: Jetson gamepad -> Teensy USB-serial drive (steer + brake + e-stop)
    USB-serial 'drive it now' path before the DBW CAN bus is wired Jetson<->Teensies.
    Reads a Logitech gamepad via the raw /dev/input/js0 kernel API (no evdev dep) and
    streams the EXACT single-char commands the Mac-proven bench firmwares accept:
    steer_test (EPAS 0x298@250k): a/d/space/x/. brake_test (Kar-Tech): w/s/e/x/.
    No firmware changes. Deadman (RB) required; BACK = latching e-stop; releasing the
    deadman or losing the process stops both actuators (firmware deadmen back it up).
    Auto-detects which ttyACM is steer vs brake by sniffing EPAS/KT status lines.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
2026-07-30 teleop_serial: guided calibration wizard + full controller inventory + analog/button brake
    - --calibrate is now a step-by-step wizard: prompts each control, detects the
    axis/button, and saves gem_gamepad_map.json (auto-loaded by the driver).
    - Records the controller's COMPLETE axis/button inventory via joystick ioctls,
    so adding controls later needs no recalibration.
    - Brake auto-adapts: analog trigger -> proportional; digital button (F710 in
    DirectInput mode, LT=btn 8) -> software ramp (hold longer = more brake).
    - D-pad = fine micro-steering (guarded so it doesn't fight stick recenter).
    - Configurable deadman/e-stop/clear + steer/dpad invert, all from the saved map.
    Jetson HID note: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
    [gem_gamepad.py]
2026-07-30 teleop_serial: robust hold-to-detect calibration wizard + auto-verify
    Rebuilt --calibrate after the first pass mis-mapped controls:
    - Hold-to-detect (control must be held ~0.35s) instead of first-spike -> rejects
    transients, D-pad snap-back, and cross-talk between steps.
    - Idle gate between every step (waits until nothing is pressed / no axis deflected).
    - Button steps require press-twice confirmation; user picks ANY button per action
    (no more 'press BACK' guessing about physical labels).
    - Atomic save (tmp + os.replace) so the map file is never half-written.
    - Auto-launches the live dry-run (--test) at the end so the mapping is verified
    before leaving the wizard.
    Also adds --monitor: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
    [gem_gamepad.py]
2026-07-30 bin: connect_eduroam.sh — configure Jetson eduroam (WPA2-Enterprise) from user creds
    Run on the Jetson; prompts for identity + hidden password, configures a
    NetworkManager 802.1X connection (PEAP/MSCHAPv2 default, EAP/PHASE2 overridable),
    brings it up, and verifies real internet via a captive-portal-proof 204 check.
    Password is read hidden and handed to NetworkManager only — never printed/uploaded.
    Only touches Wi-Fi, so the 192.168.55.1 USB SSH link can't be lost.
    Claude-Session: https://claude.ai/code/session_01Rkn7r1nJNFr4nkz9BtgELY
